stevesirois/airq/photos/Seeed-xiao-esp32-c6-airq-pinout.png

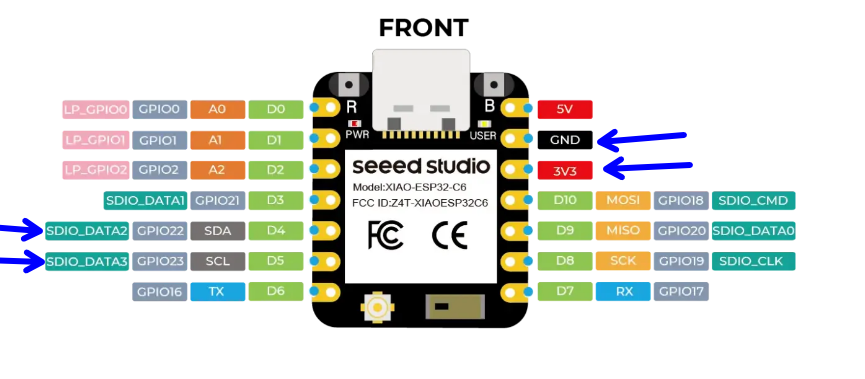
photos/Seeed-xiao-esp32-c6-airq-pinout.png
