stevesirois/airq/photos/back-side.jpeg

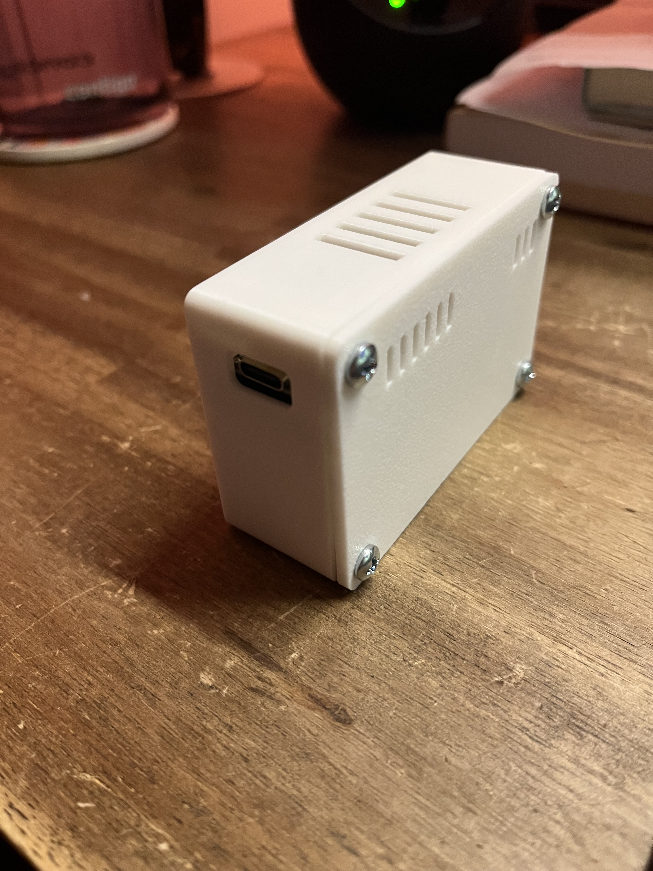
photos/back-side.jpeg
