stevesirois/airq/photos/front.jpeg

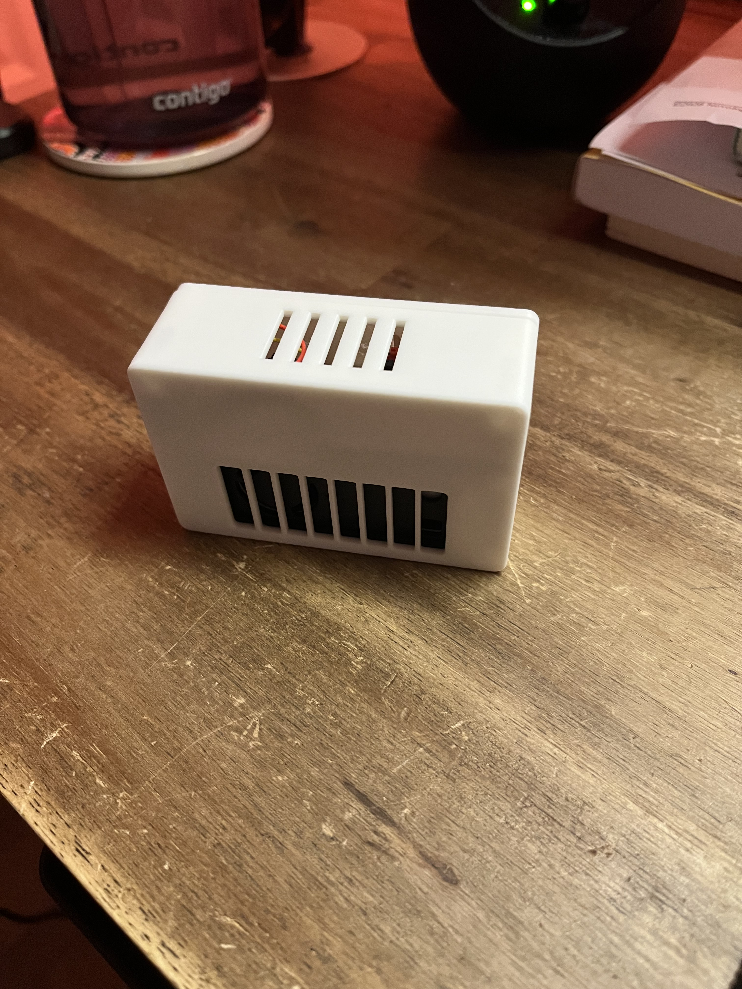
photos/front.jpeg
