stevesirois/airq/photos/home-assistant-HACS-Air Quality Card-KadenThomp36.png

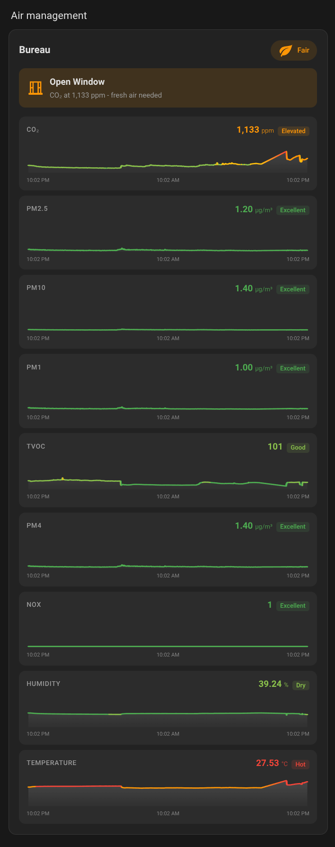
photos/home-assistant-HACS-Air Quality Card-KadenThomp36.png
