stevesirois/airq/photos/PCB-populated.jpeg

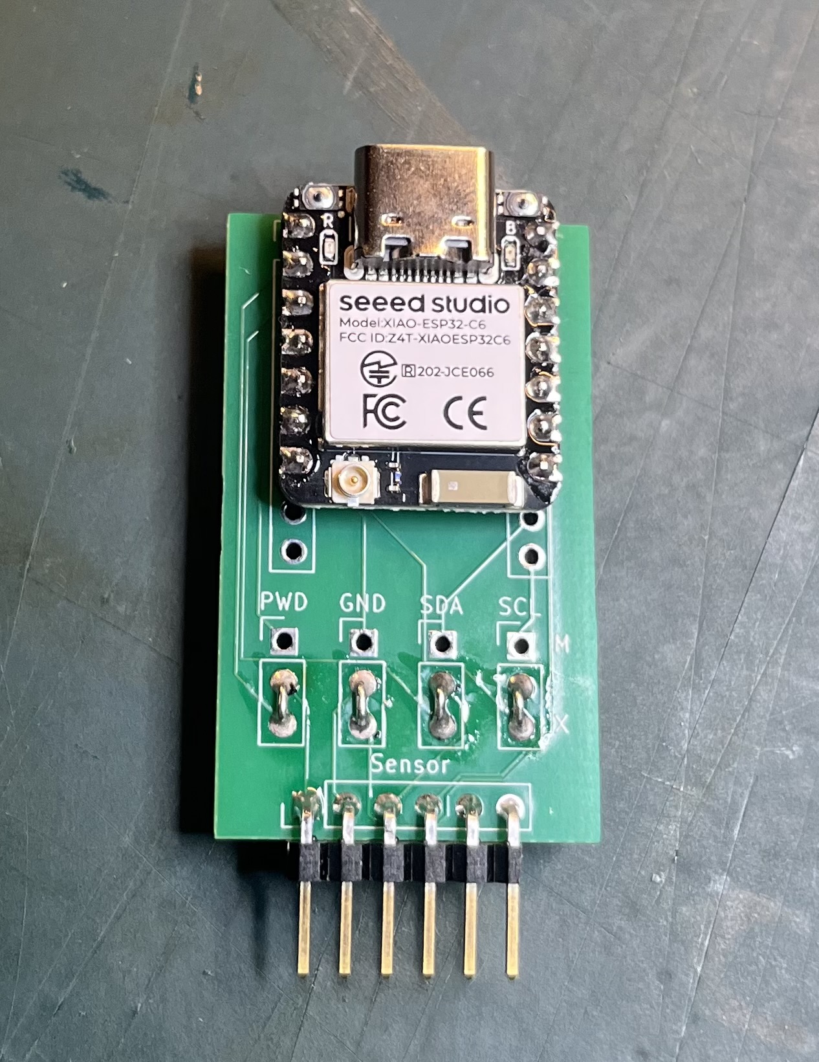
photos/PCB-populated.jpeg
