stevesirois/airq/3D-Print/SEN66_enclosure_assembly.step

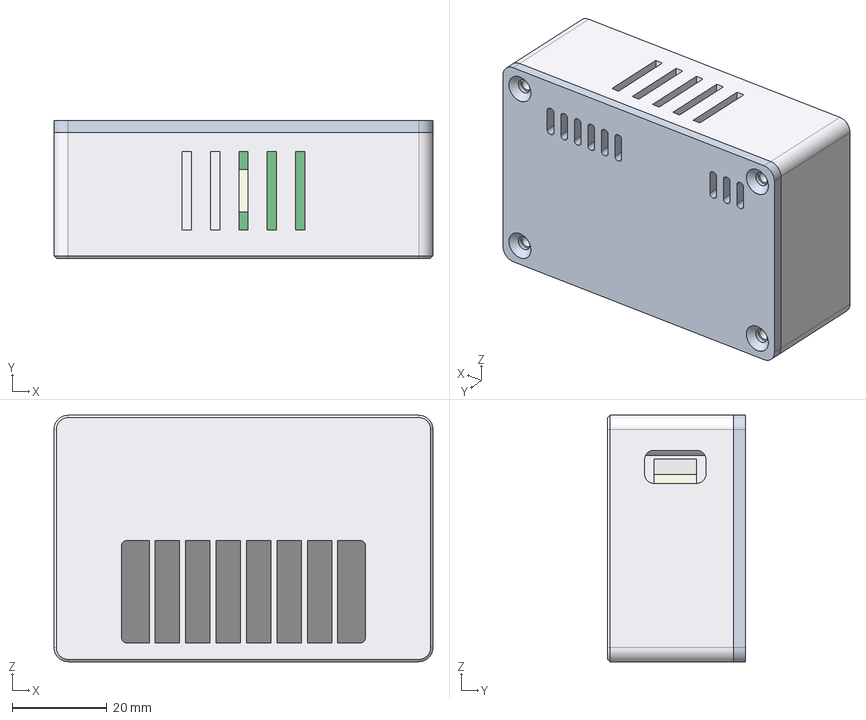
[picture p7: CAD file, 2026-11-03]
3D-Print/SEN66_enclosure_assembly.step
80.1 x 29.1 x 52.1 mm
cover
gasket
SEN66_dummy
PCB_dummy
USB_C_dummy
sensor_cable_conn_dummy
