stevesirois/airq/3D-Print/SEN66_enclosure_gasket_TPU.step

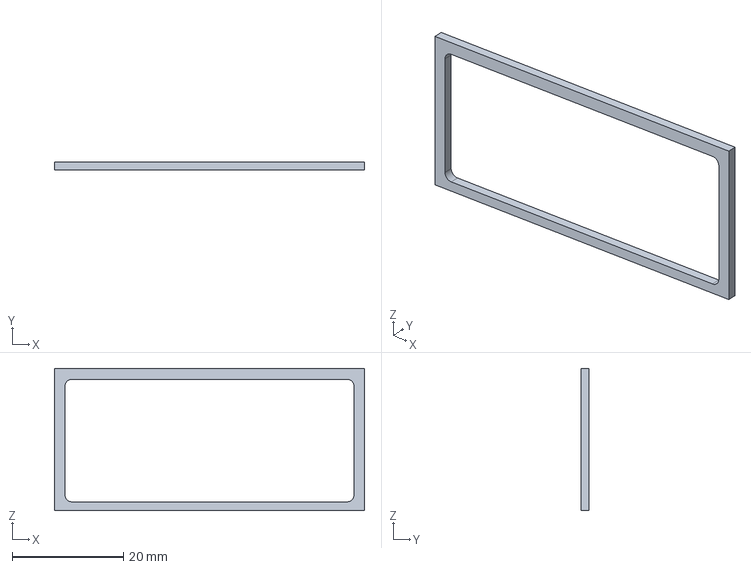
[picture p8: CAD file, 2026-11-03]
3D-Print/SEN66_enclosure_gasket_TPU.step
55.7 x 1.50 x 25.6 mm
