stevesirois/airq/3D-Print/SEN66_enclosure_cover.step

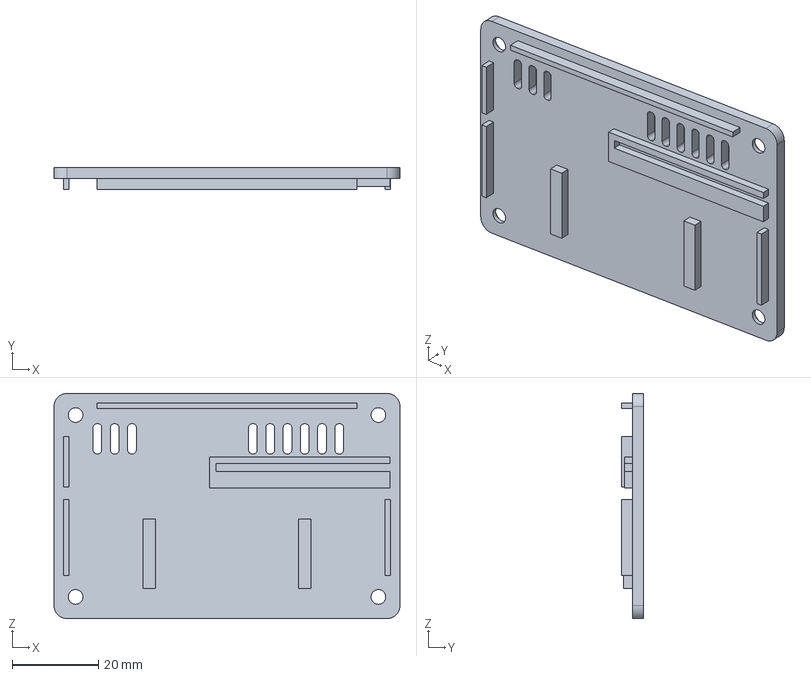
[picture p9: CAD file, 2026-11-03]
3D-Print/SEN66_enclosure_cover.step
80.1 x 5.00 x 52.1 mm
