stevesirois/airq/3D-Print/SEN66_enclosure_body.step

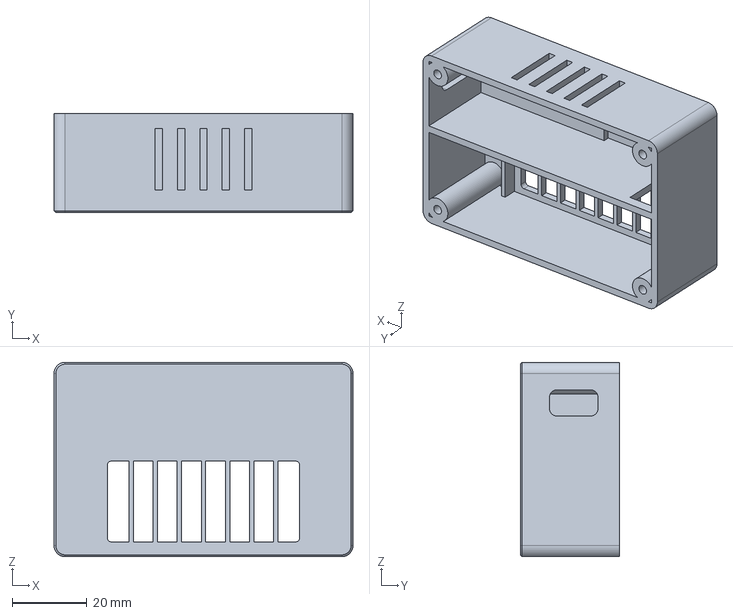
[picture p10: CAD file, 2026-11-03]
3D-Print/SEN66_enclosure_body.step
80.1 x 26.6 x 52.1 mm
