stevesirois/airq/(list of files, cad)

Other CAD files:
3D-Print/SEN66_enclosure_body.stl
3D-Print/SEN66_enclosure_cover.3mf
3D-Print/SEN66_enclosure_cover.stl
3D-Print/SEN66_enclosure_gasket_TPU.stl
