stevesirois/airq/airQ (PCB)/airQ.kicad_pcb

## KiCad design airQ (PCB)/airQ.kicad_pcb (2026-11-03)

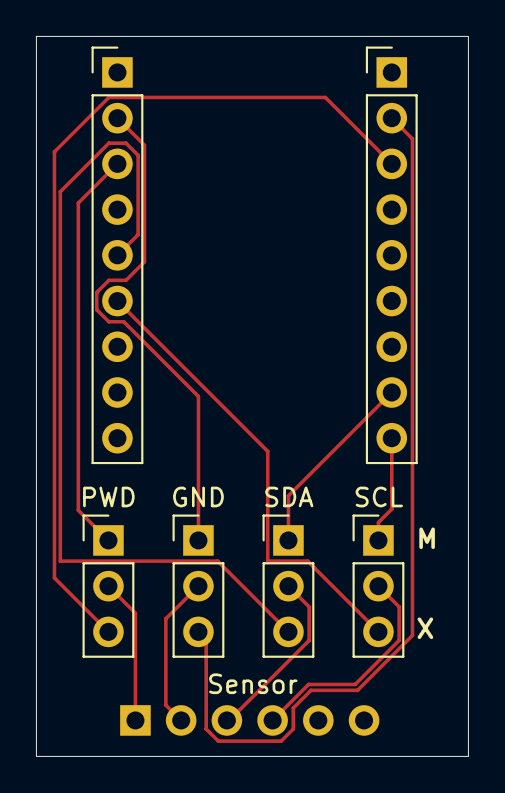
[picture p11: board airQ.kicad_pcb from above]

Board: 2 copper layers, 24.0 x 40.0 mm, 7 parts (1 on the bottom side), 12 nets.

Parts:
GND: Conn_01x03_Pin; PinHeader_1x03_P2.54mm_Vertical
LeftRow1: Conn_01x09_Pin; PinHeader_1x09_P2.54mm_Vertical
PWD: Conn_01x03_Pin; PinHeader_1x03_P2.54mm_Vertical
RightRow1: Conn_01x09_Pin; PinHeader_1x09_P2.54mm_Vertical
SCL: Conn_01x03_Pin; PinHeader_1x03_P2.54mm_Vertical
SDA: Conn_01x03_Pin; PinHeader_1x03_P2.54mm_Vertical
Sensor: Conn_01x06_Pin; PinHeader_1x06_P2.54mm_Vertical

Connections:
unnamed: GND.1, LeftRow1.2
unnamed: GND.2, Sensor.2
unnamed: GND.3, RightRow1.2
unnamed: LeftRow1.3, PWD.1
unnamed: LeftRow1.5, SDA.3
unnamed: LeftRow1.6, SCL.3
unnamed: PWD.2, Sensor.1
unnamed: PWD.3, RightRow1.3
unnamed: RightRow1.8, SDA.1
unnamed: RightRow1.9, SCL.1
unnamed: SCL.2, Sensor.4
unnamed: SDA.2, Sensor.3
