stevesirois/airq/3D-Print/SEN66_enclosure_preview.png

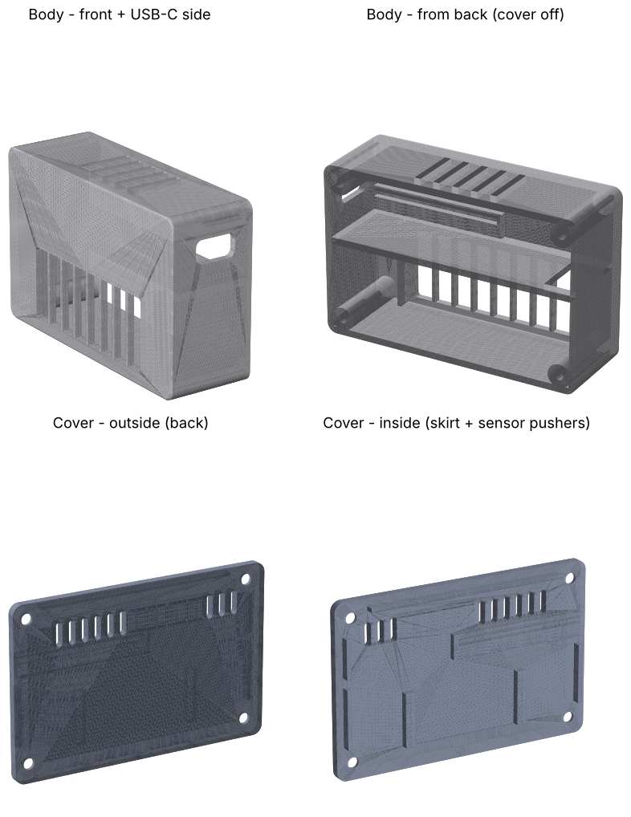
3D-Print/SEN66_enclosure_preview.png
