stevesirois/airq/3D-Print/SEN66_enclosure_sections.png

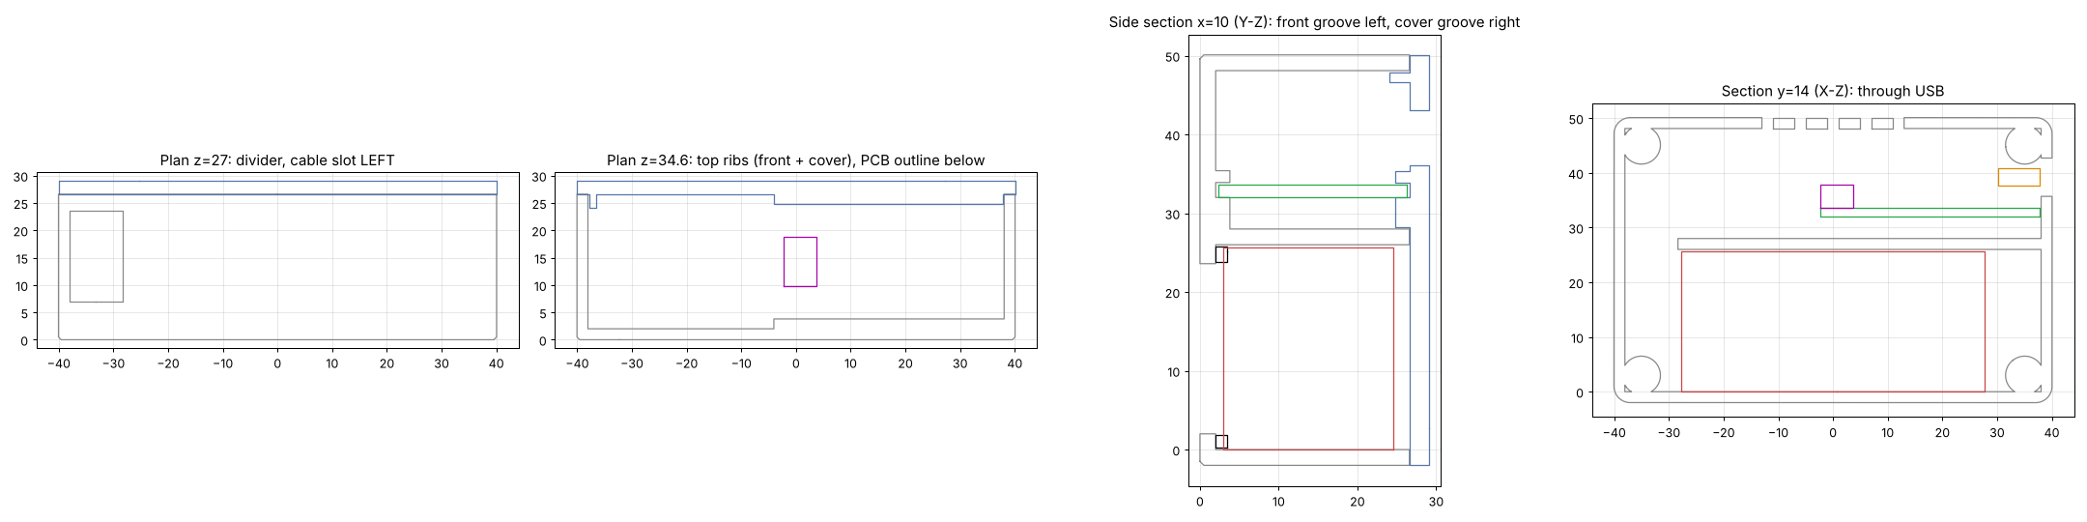
3D-Print/SEN66_enclosure_sections.png
