stevesirois/airq/(commit log)

2026-11-03 Add initial production files and configuration for AirQ and AirQX boards
    [BOM.ods, SEN66_enclosure_assembly.step, SEN66_enclosure_body.step, SEN66_enclosure_body.stl, SEN66_enclosure_cover.3mf, SEN66_enclosure_cover.step, SEN66_enclosure_cover.stl, SEN66_enclosure_gasket_TPU.step]
2026-11-03 Add Bill of Materials (BOM) for AirQ project in CSV format
    [BOM.csv]
2026-11-03 Home Assistan Printscreen
2026-11-07 Added new image of PCB + clarification for HA dashboard
2026-11-07 Update README to include BOM.csv in the Bill of Materials section
