stevesirois/airq/photos/open-box.jpeg

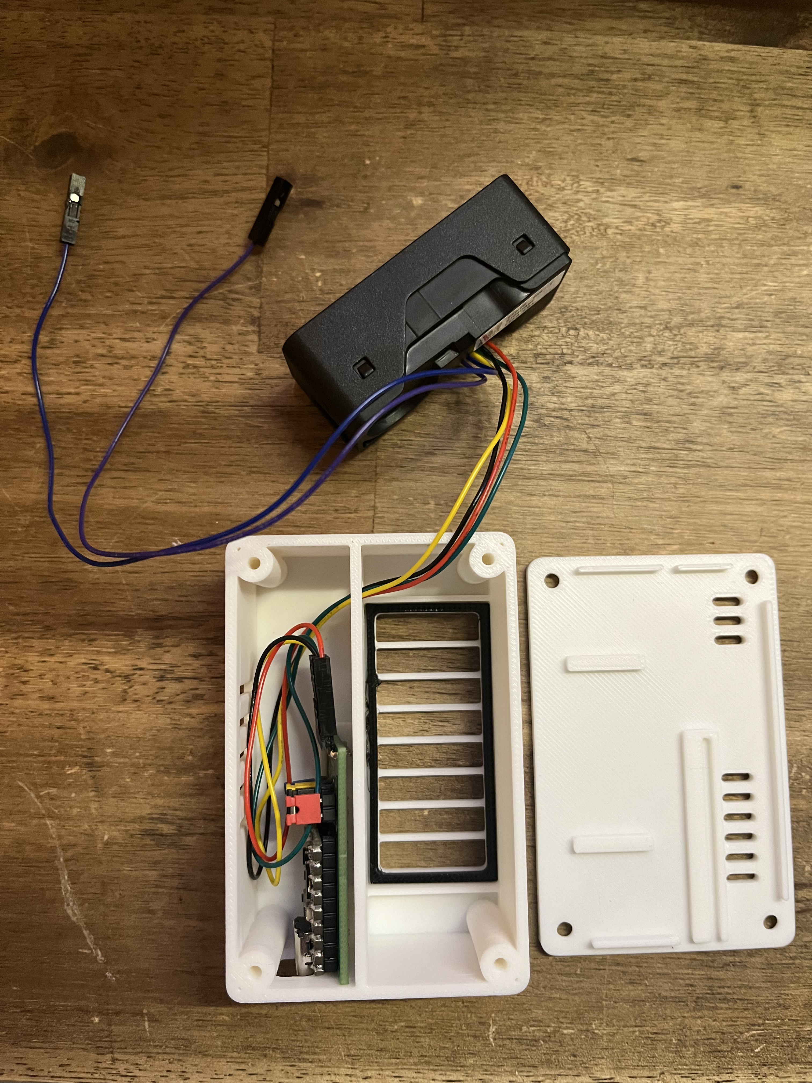
photos/open-box.jpeg
